ytmytm/c16-keyboard/docs/c16-keyboard.jpg

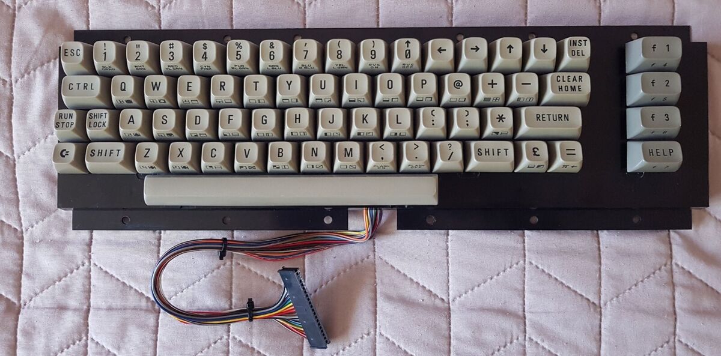
docs/c16-keyboard.jpg
