ytmytm/c16-keyboard/docs/plus4-layout.png

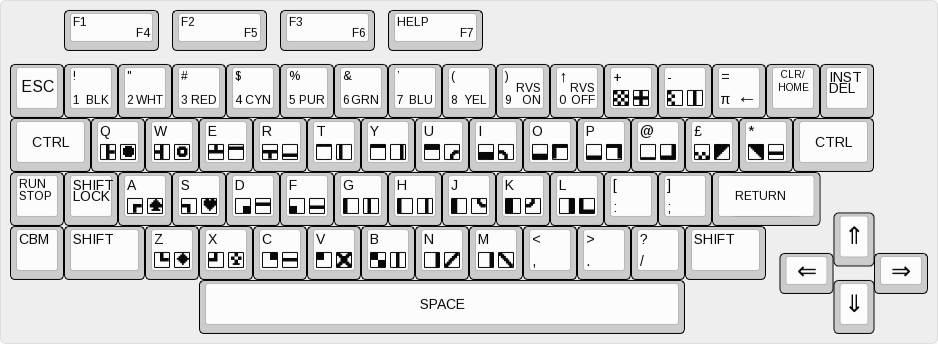
docs/plus4-layout.png
