ytmytm/c16-keyboard/docs/vice-plus4-symbolic-keymap-us.png

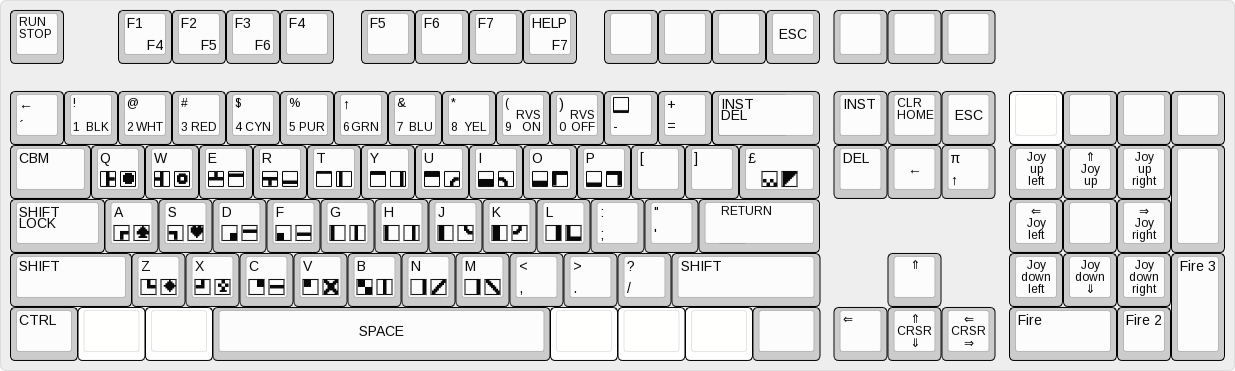
docs/vice-plus4-symbolic-keymap-us.png
