ytmytm/c16-keyboard/media/01.pcbforc16.jpg

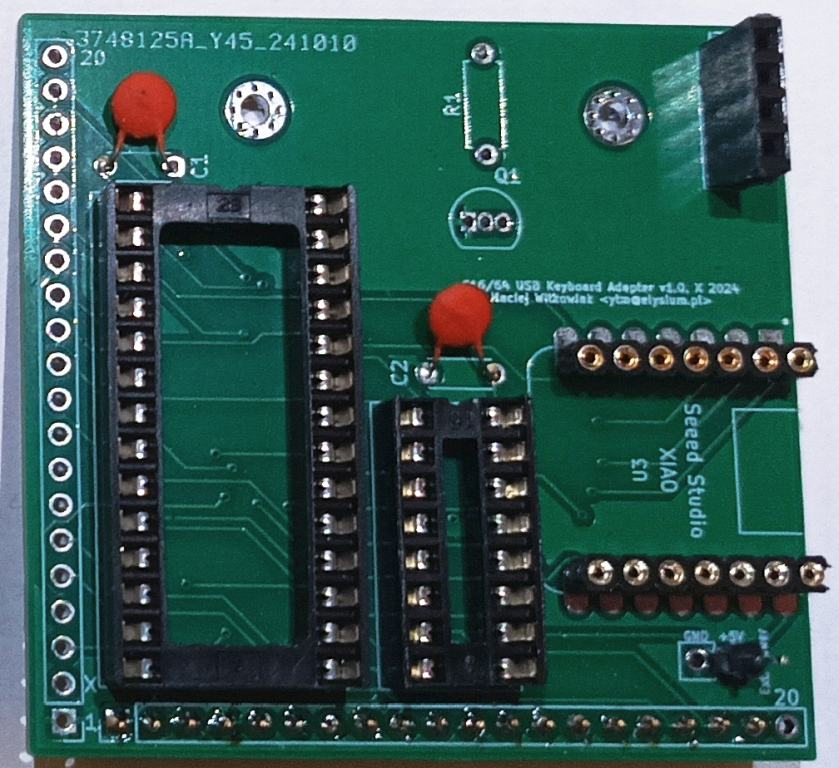
media/01.pcbforc16.jpg
