ytmytm/c16-keyboard/kicad-c128keyb/plots/kicad-c128keyb.pdf

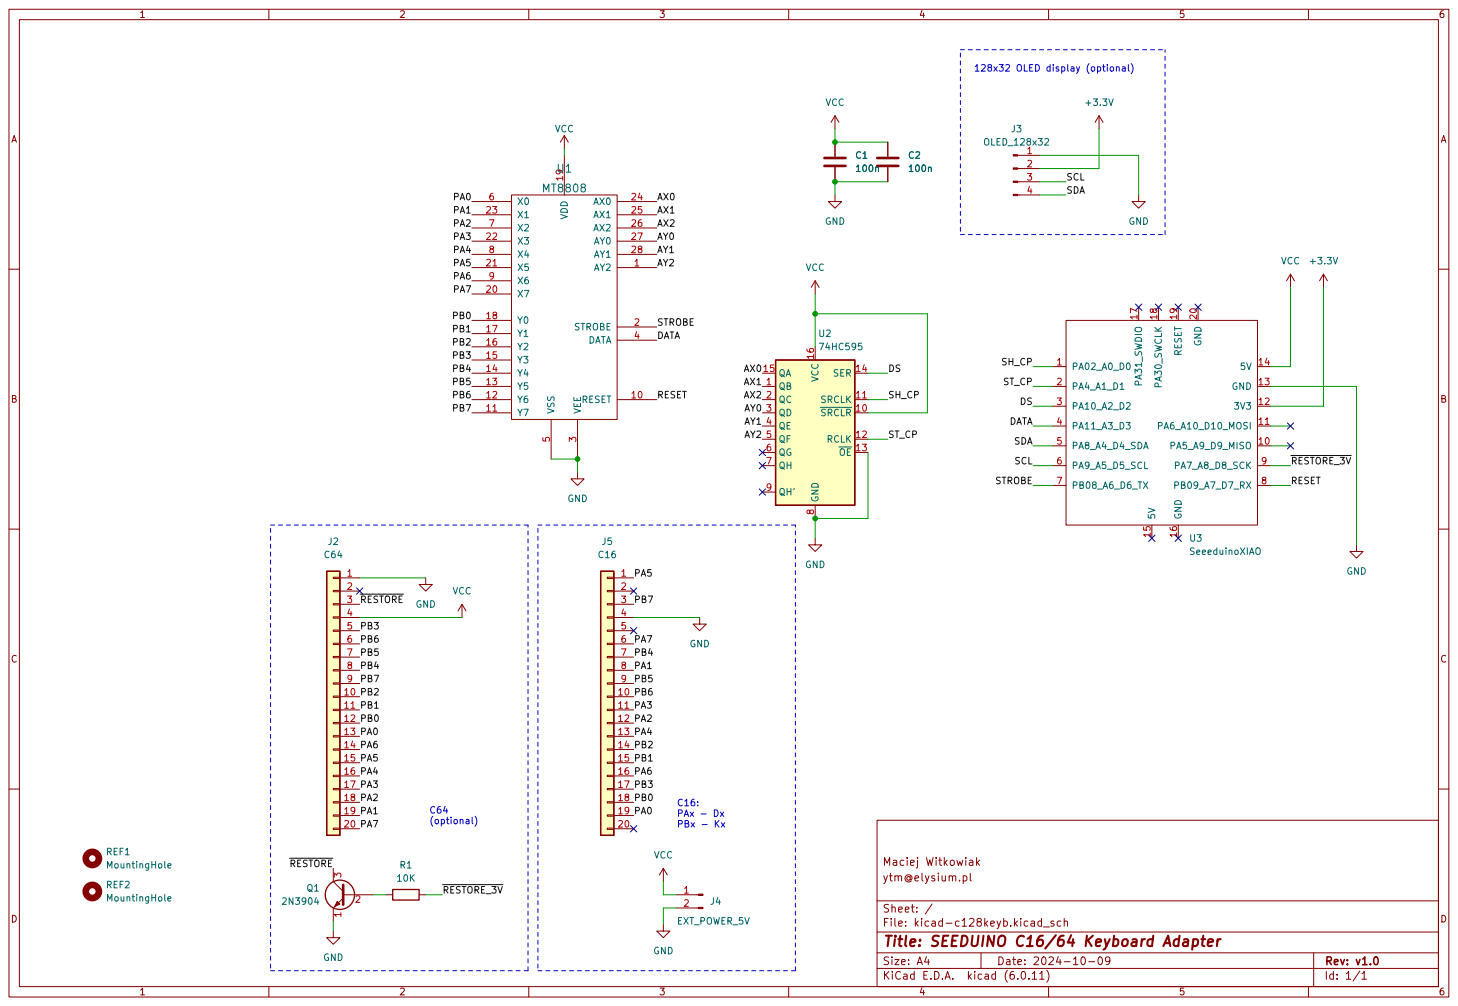
[picture p8: page 1]
