ytmytm/c16-keyboard/kicad-c128keyb/kicad-c128keyb.kicad_pcb

## KiCad design kicad-c128keyb/kicad-c128keyb.kicad_pcb (2024-10-09)

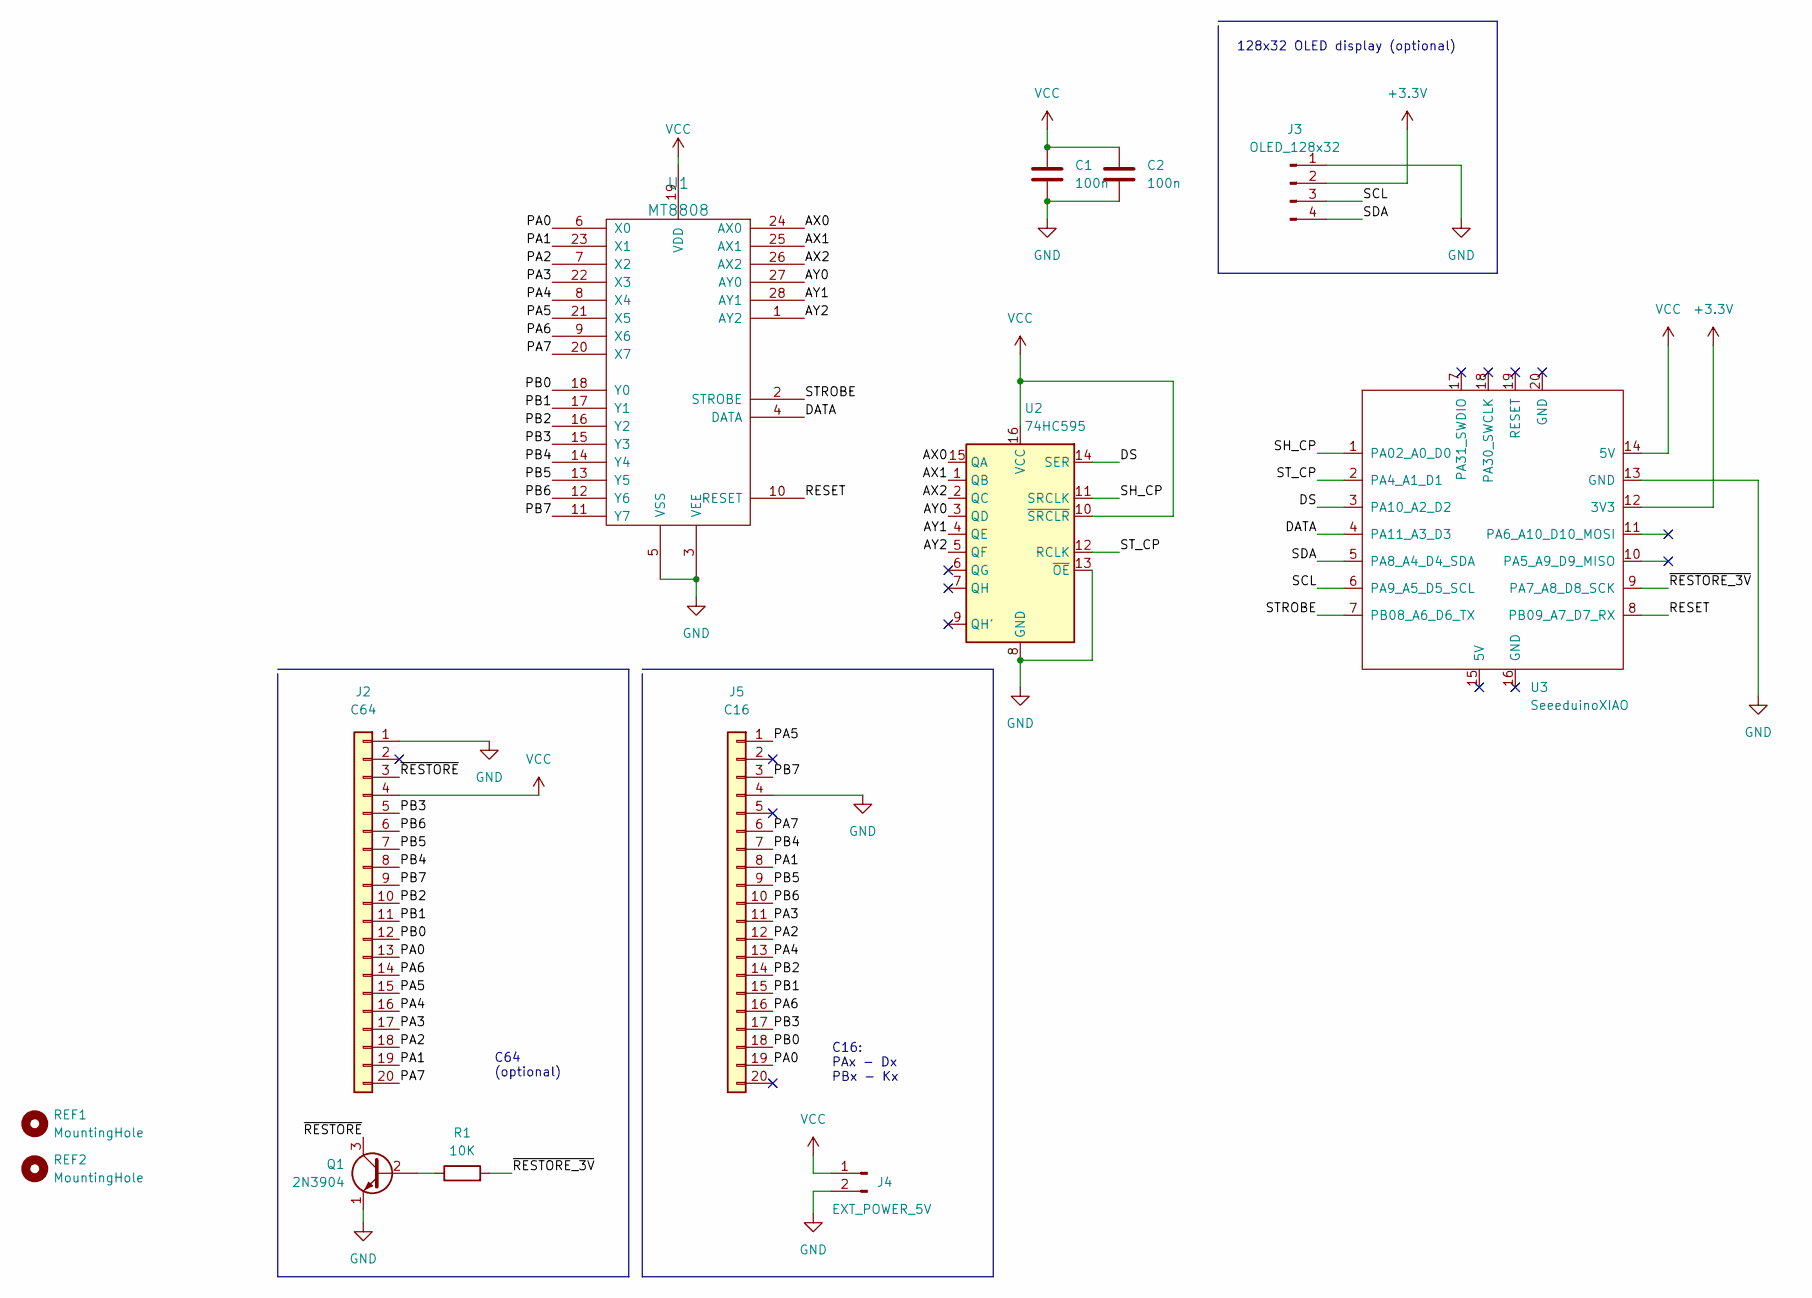
[picture p9: schematic kicad-c128keyb.kicad_sch, SEEDUINO C16/64 Keyboard Adapter]

Parts:
C1, C2: 100n; C_Disc_D4.3mm_W1.9mm_P5.00mm
J2: C64; PinHeader_1x20_P2.54mm_Vertical
J3: OLED_128x32; PinHeader_1x04_P2.54mm_Vertical
J4: EXT_POWER_5V; PinHeader_1x02_P2.54mm_Vertical
J5: C16; PinHeader_1x20_P2.54mm_Vertical
Q1: 2N3904; TO-92_Inline
R1: 10K; R_Axial_DIN0207_L6.3mm_D2.5mm_P7.62mm_Horizontal
REF1, REF2: MountingHole; MountingHole_2.2mm_M2_Pad_Via
U1: MT8808; DIP-28_W15.24mm_Socket
U2: 74HC595; DIP-16_W7.62mm_Socket
U3: SeeeduinoXIAO; XIAO-Generic-Hybrid-14P-2.54-21X17.8MM

Connections:
+3V3: J3.2, U3.12 (3V3)
/AX0: U1.24 (AX0), U2.15 (QA)
/AX1: U1.25 (AX1), U2.1 (QB)
/AX2: U1.26 (AX2), U2.2 (QC)
/AY0: U1.27 (AY0), U2.3 (QD)
/AY1: U1.28 (AY1), U2.4 (QE)
/AY2: U1.1 (AY2), U2.5 (QF)
/DATA: U1.4 (DATA), U3.4 (PA11_A3_D3)
/DS: U2.14 (SER), U3.3 (PA10_A2_D2)
/PA0: J2.13, J5.19, U1.6 (X0)
/PA1: J2.19, J5.8, U1.23 (X1)
/PA2: J2.18, J5.12, U1.7 (X2)
/PA3: J2.17, J5.11, U1.22 (X3)
/PA4: J2.16, J5.13, U1.8 (X4)
/PA5: J2.15, J5.1, U1.21 (X5)
/PA6: J2.14, J5.16, U1.9 (X6)
/PA7: J2.20, J5.6, U1.20 (X7)
/PB0: J2.12, J5.18, U1.18 (Y0)
/PB1: J2.11, J5.15, U1.17 (Y1)
/PB2: J2.10, J5.14, U1.16 (Y2)
/PB3: J2.5, J5.17, U1.15 (Y3)
/PB4: J2.8, J5.7, U1.14 (Y4)
/PB5: J2.7, J5.9, U1.13 (Y5)
/PB6: J2.6, J5.10, U1.12 (Y6)
/PB7: J2.9, J5.3, U1.11 (Y7)
/RESET: U1.10 (RESET), U3.8 (PB09_A7_D7_RX)
/SCL: J3.3, U3.6 (PA9_A5_D5_SCL)
/SDA: J3.4, U3.5 (PA8_A4_D4_SDA)
/SH_CP: U2.11 (SRCLK), U3.1 (PA02_A0_D0)
/STROBE: U1.2 (STROBE), U3.7 (PB08_A6_D6_TX)
/ST_CP: U2.12 (RCLK), U3.2 (PA4_A1_D1)
/~RESTORE_3V: R1.2, U3.9 (PA7_A8_D8_SCK)
/~RESTORE: J2.3, Q1.3 (C)
GND: C1.2, C2.2, J2.1, J3.1, J4.2, J5.4, Q1.1 (E), U1.3 (VEE), U1.5 (VSS), U2.8 (GND), U2.13 (~OE), U3.13 (GND)
unnamed: Q1.2 (B), R1.1
VCC: C1.1, C2.1, J2.4, J4.1, U1.19 (VDD), U2.10 (~SRCLR), U2.16 (VCC), U3.14 (5V)

Notes on the sheet:
C16: PAx - Dx PBx - Kx
C64 (optional)
128x32 OLED display (optional)

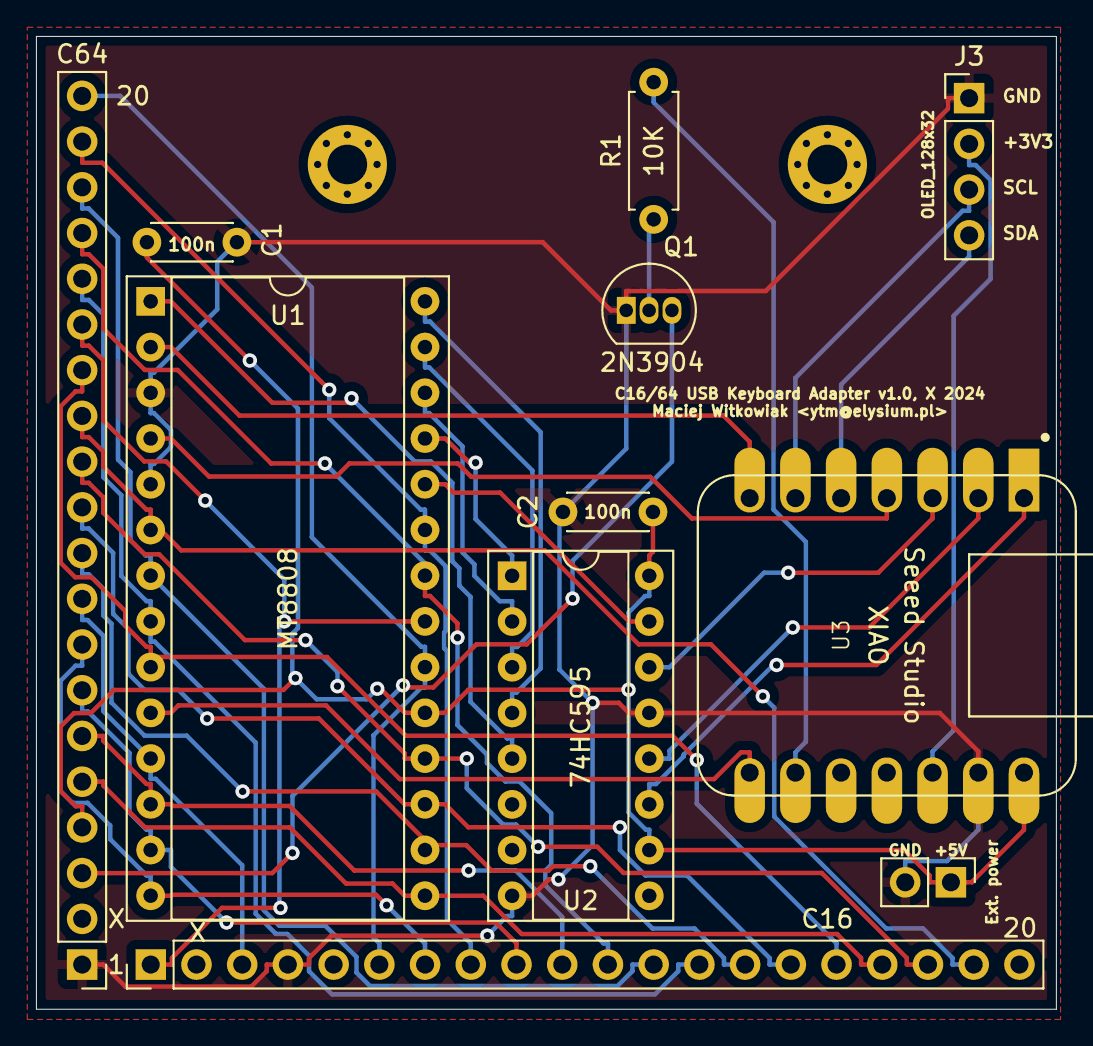
[picture p10: board kicad-c128keyb.kicad_pcb from above]

Board: 2 copper layers, 56.7 x 54.0 mm, 13 parts (0 on the bottom side), 36 nets.
