ytmytm/c16-keyboard/(commit log)

2024-10-09 common C16/C64 version for internal mount; despite filenames this is not about C128 anymore; downgraded from MT8816 to MT8808
    [kicad-c128keyb-B_Cu.gbl, kicad-c128keyb-B_Mask.gbs, kicad-c128keyb-B_Silkscreen.gbo, kicad-c128keyb-Edge_Cuts.gm1, kicad-c128keyb-F_Cu.gtl, kicad-c128keyb-F_Mask.gts, kicad-c128keyb-F_Silkscreen.gto, kicad-c128keyb-NPTH-drl_map.gbr]
2024-10-15 move folder to C16
    [KEYBIN_calc_c128.xlsx]
2024-10-16 correct slash/dot/comma confusion
    [C16 keyboard.xlsm]
2024-10-16 new PCB render
2024-10-16 C64 firmware
    [KEYBIN_calc_c128.xlsx]
2024-10-22 fix for missed key release events (e.g. in symbolic mapping after shift+' for double-quote, shift had to be released last)
    [C16_keyboard.ino, C16keyboard.c.ino, C16keyboard.h]
2024-10-22 don't use u8g2 if the display is not connecte (i2c address 0x3c)
2024-10-24 don't use u8g2 if the display is not connected (i2c address 0x3c)
2024-10-24 drop unneeded file
    [KEYBIN_calc_c128.xlsx]
